OPEnSLab-OSU/OPEnS-RTC/OPEnS-RTC-1.1.brd

## EAGLE design OPEnS-RTC-1.1.brd (2019-06-27)

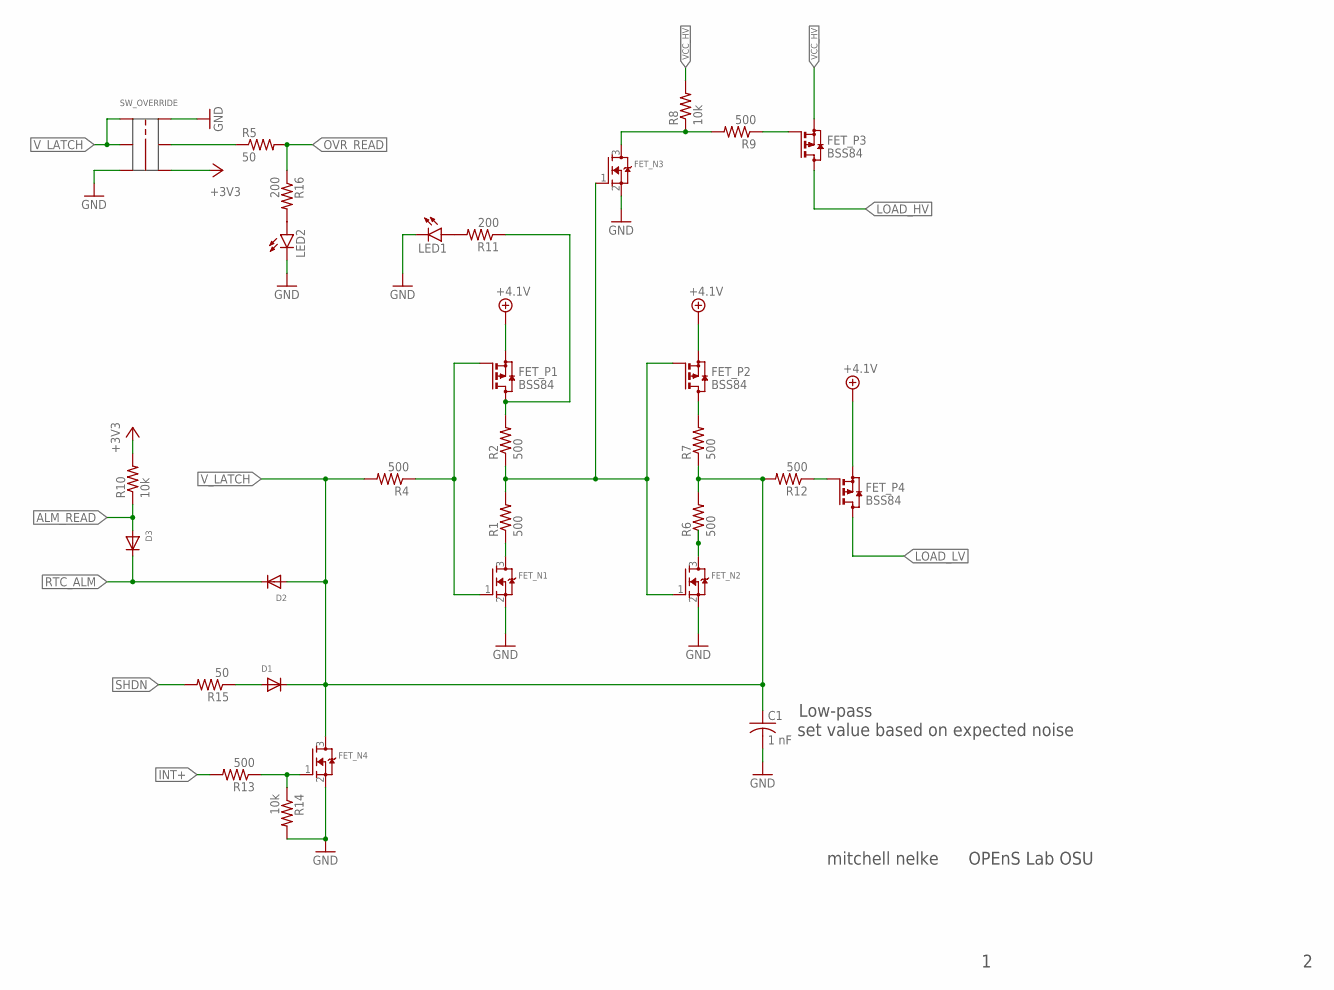
[picture p3: schematic OPEnS-RTC-1.1.sch, sheet 1]

Parts:
C1: 1 nF; C0805
D1, D2, D3: DIODESOD-123; SOD-123
FET_N1, FET_N2, FET_N3, FET_N4: MOSFET-NREFLOW; SOT23
FET_P1, FET_P2, FET_P3, FET_P4: BSS84; SOT23
LED1, LED2: LEDSMT1206; 1206
R1, R2, R4, R6, R7, R9, R12, R13: 500; R0805
R5, R15: 50; R0805
R8, R10, R14: 10k; R0805
R11, R16: 200; R0805
SW_OVERRIDE: JS202011JCQN; VERTICAL_MNT_SMT-J

Connections:
+3V3: R10.2, SW_OVERRIDE.A_; also elsewhere on the board
+4.1V: FET_P1.2 (S), FET_P2.2 (S), FET_P4.2 (S); also elsewhere on the board
ALM_READ: D3.A, R10.1; also elsewhere on the board
GND: C1.2, FET_N1.2 (S), FET_N2.2 (S), FET_N3.2 (S), FET_N4.2 (S), LED1.C, LED2.C, R14.2, SW_OVERRIDE.A, SW_OVERRIDE.B_; also elsewhere on the board
INT+: R13.2; also elsewhere on the board
LOAD_HV: FET_P3.3 (D); also elsewhere on the board
LOAD_LV: FET_P4.3 (D); also elsewhere on the board
unnamed: FET_P1.3 (D), R2.2, R11.1
unnamed: FET_N1.3 (D), R1.1
unnamed: FET_N1.1 (G), FET_P1.1 (G), R4.1
unnamed: FET_N2.1 (G), FET_N3.1 (G), FET_P2.1 (G), R1.2, R2.1
unnamed: FET_N3.3 (D), R8.1, R9.2
unnamed: FET_P2.3 (D), R7.2
unnamed: FET_N2.3 (D), R6.1
unnamed: FET_P3.1 (G), R9.1
unnamed: LED1.A, R11.2
unnamed: FET_P4.1 (G), R12.1
unnamed: D1.A, R15.1
unnamed: FET_N4.1 (G), R13.1, R14.1
unnamed: LED2.A, R16.2
unnamed: R5.1, SW_OVERRIDE.COM_
OVR_READ: R5.2, R16.1; also elsewhere on the board
RTC_ALM: D2.C, D3.C; also elsewhere on the board
SHDN: R15.2; also elsewhere on the board
VCC_HV: FET_P3.2 (S), R8.2; also elsewhere on the board
V_LATCH: C1.1, D1.C, D2.A, FET_N4.3 (D), R4.2, R6.2, R7.1, R12.2, SW_OVERRIDE.B, SW_OVERRIDE.COM; also elsewhere on the board

Notes on the sheet:
mitchell nelke
OPEnS Lab OSU
Low-pass
set value based on expected noise

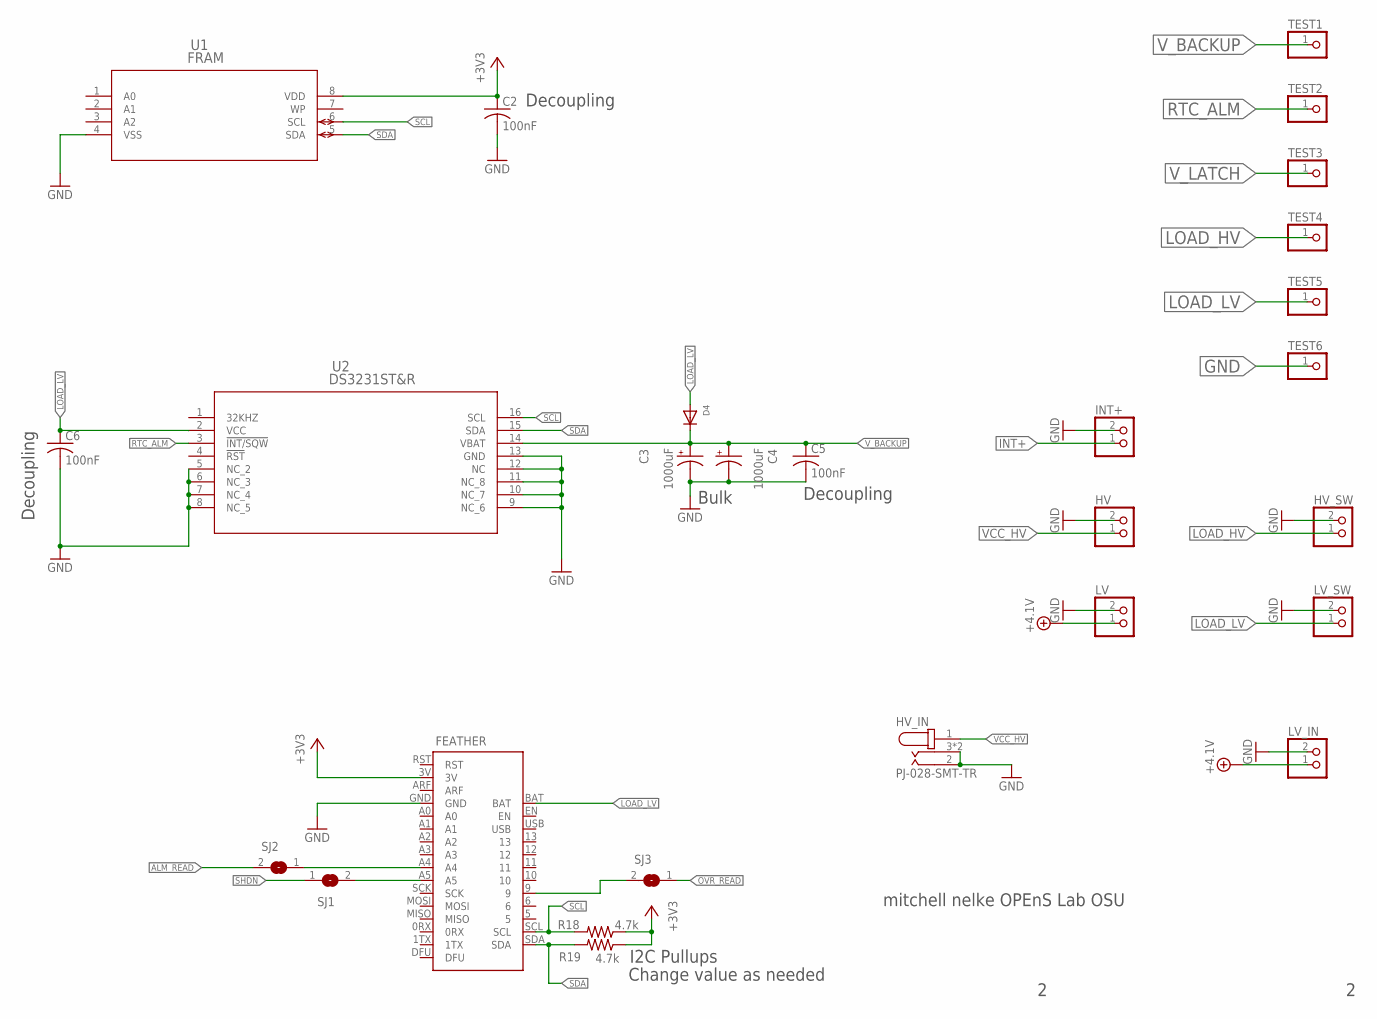
[picture p4: schematic OPEnS-RTC-1.1.sch, sheet 2]

Parts:
C2, C5, C6: 100nF; C0805
C3, C4: 1000uF; E3,5-8
D4: DIODESOD-123; SOD-123
FEATHER: BLUEFRUIT_M0; BLUEFRUIT_MO
HV: JST_2PIN-SMT; JST-PH-2-SMT
HV_IN: PJ-028-SMT-TR; CUI_PJ-028-SMT-TR
HV_SW: JST_2PIN-SMT; JST-PH-2-SMT
INT+: JST_2PIN-SMT; JST-PH-2-SMT
LV: JST_2PIN-SMT; JST-PH-2-SMT
LV_IN: JST_2PIN-SMT; JST-PH-2-SMT
LV_SW: JST_2PIN-SMT; JST-PH-2-SMT
R18, R19: 4.7k; M0805
SJ1, SJ2, SJ3: SJ
TEST1, TEST2, TEST3, TEST4, TEST5, TEST6: PINHD-1X1; 1X01
U1: FRAM; FPT-8P-M02
U2: DS3231ST&R; 21-0042B_16

Connections:
+3V3: C2.1, FEATHER.3V, R18.1, R19.1, U1.8 (VDD); also elsewhere on the board
+4.1V: LV.1 (2), LV_IN.1 (2); also elsewhere on the board
ALM_READ: SJ2.2; also elsewhere on the board
GND: C2.2, C3.-, C4.-, C5.2, C6.2, FEATHER.GND, HV.2 (1), HV_IN.2, HV_IN.3, HV_IN.3.1 (3), HV_SW.2 (1), INT+.2 (1), LV.2 (1), LV_IN.2 (1), LV_SW.2 (1), TEST6.1, U1.4 (VSS), U2.5 (NC_2), U2.6 (NC_3), U2.7 (NC_4), U2.8 (NC_5), U2.9 (NC_6), U2.10 (NC_7), U2.11 (NC_8), U2.12 (NC), U2.13 (GND); also elsewhere on the board
INT+: INT+.1 (2); also elsewhere on the board
LOAD_HV: HV_SW.1 (2), TEST4.1; also elsewhere on the board
LOAD_LV: C6.1, D4.A, FEATHER.BAT, LV_SW.1 (2), TEST5.1, U2.2 (VCC); also elsewhere on the board
unnamed: FEATHER.A4, SJ2.1
unnamed: FEATHER.A5, SJ1.2
unnamed: FEATHER.9, SJ3.2
OVR_READ: SJ3.1; also elsewhere on the board
RTC_ALM: TEST2.1, U2.3 (!INT/SQW); also elsewhere on the board
SCL: FEATHER.SCL, R18.2, U1.6 (SCL), U2.16 (SCL)
SDA: FEATHER.SDA, R19.2, U1.5 (SDA), U2.15 (SDA)
SHDN: SJ1.1; also elsewhere on the board
VCC_HV: HV.1 (2), HV_IN.1; also elsewhere on the board
V_BACKUP: C3.+, C4.+, C5.1, D4.C, TEST1.1, U2.14 (VBAT)
V_LATCH: TEST3.1; also elsewhere on the board

Notes on the sheet:
mitchell nelke OPEnS Lab OSU
Decoupling
Bulk
I2C Pullups
Change value as needed

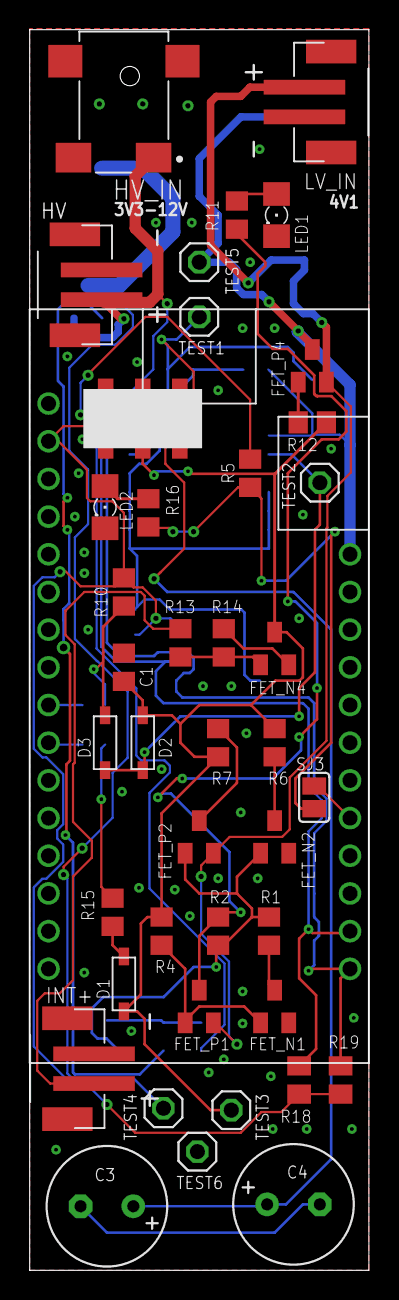
[picture p5: board OPEnS-RTC-1.1.brd from above]

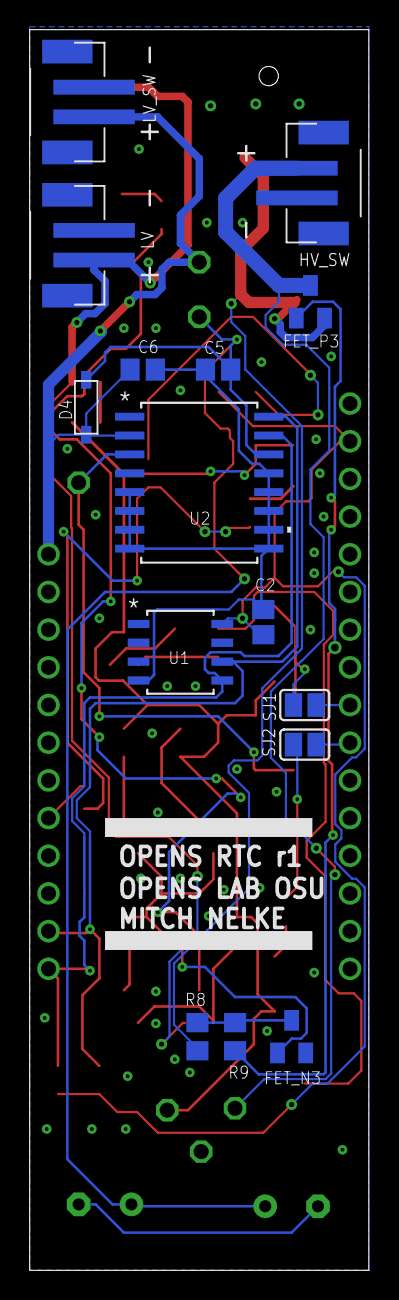
[picture p6: board OPEnS-RTC-1.1.brd from below]

Board: 2 copper layers, 22.9 x 83.6 mm, 57 parts (15 on the bottom side), 32 nets.
