OPEnSLab-OSU/OPEnS-RTC/(commit log)

2019-06-24 First upload switching from OPEnS Power to OPEnS RTC
    [OPEnS-RTC-1.0.brd, OPEnS-RTC-1.0.sch]
2019-06-27 Revised components and labels.
    Added documentation (with BoM) as a .docx and .pdf. Swapped pins on JST connectors. Removed pointless pullup resistor, added current limiting resistor for LED. Swapped 2mm barrel jack for 0.9mm x 3.2mm barrel jack. Combined components into OPEnS-RTC.lbr.
    [OPEnS-RTC-1.1.brd, OPEnS-RTC-1.1.sch]
